re-lamb/ECE411_team14/Prototype/prototype1.jpg

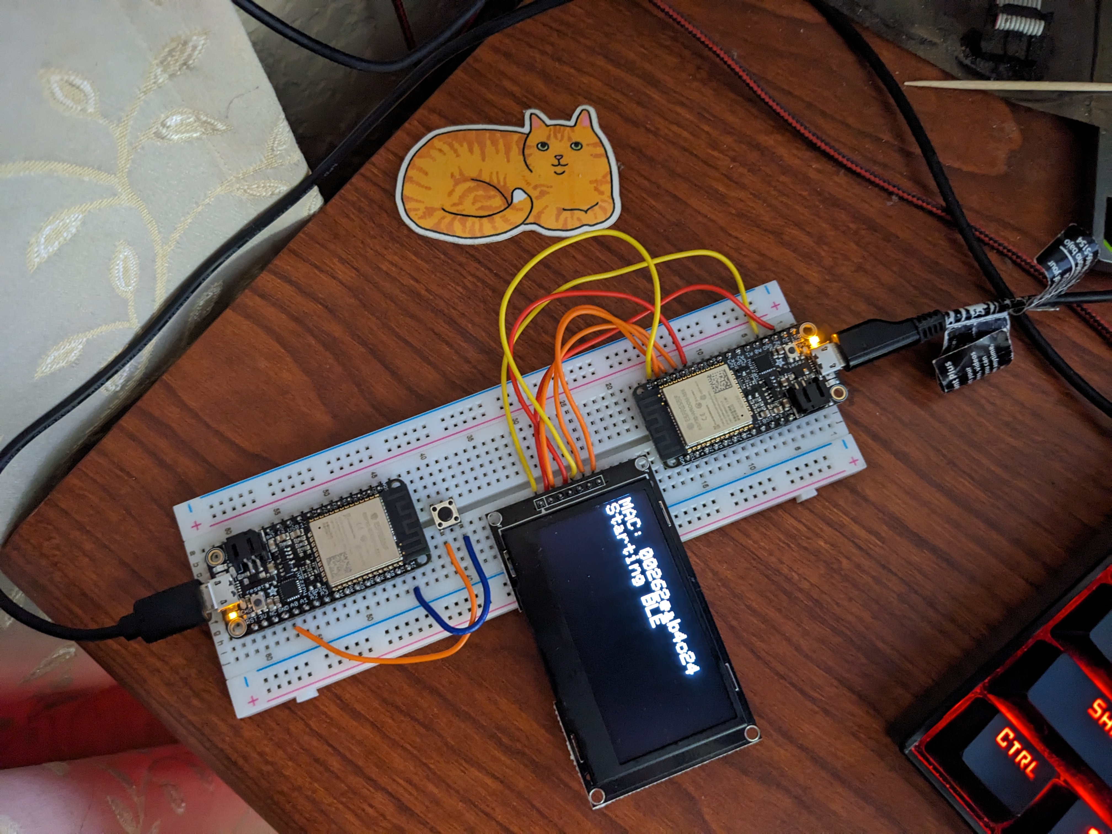
Prototype/prototype1.jpg
