re-lamb/ECE411_team14/README.md

# ECE411_team14
practicum for ece411 fall '23
