re-lamb/ECE411_team14/Documentation/Functional Decompositions - Team 14.pdf

Functional Decompositions
Team 14

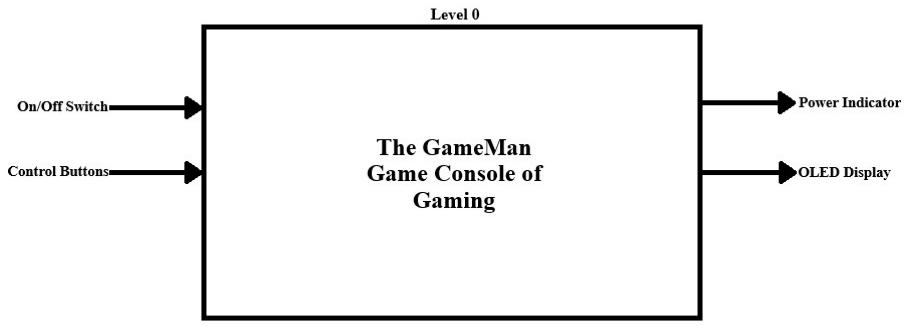
[picture p4: figure]
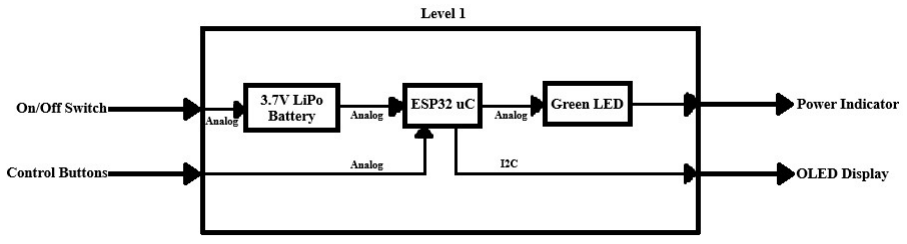
[picture p5: figure]
