re-lamb/ECE411_team14/Schematics/mazeye.gif

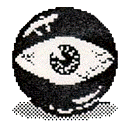
Schematics/mazeye.gif
