re-lamb/ECE411_team14/Scheduling/ECE411-GRP14_BILL.xlsx

Bill Of Materials for: Team 14
Last modified: 11/10/23
PCB version: 1
BOM revision: 1 |  | P/NP | = Place/Not Place (components marked NP are not stuffed on the board)
Cnt | Part References | P/NP | Mfg | Mfg PN | Description | Dist | Dist Part Number | Cost Ea. | Cost Total
1 |  | P | Adafruit Industries LLC | CFAL128128A0-015Y | MONOCHROME 1.12" 128X128 OLED | Digi-Key | 1528-5297-ND | $17.02 | $17.02
1 |  | P | RF Solutions | ESP-32 | Adafruit HUZZAH32 – ESP32 Feather Board | Digi-Key | ESP-32-ND | $10.00 | $10.00
1 | R4 | P | Stackpole Electronics INC | CF14JT330R | RES 330 OHM 5% 1/4W AXIAL | Digi-Key | CF14JT330RTR-ND | $0.10 | $0.10
1 | J1, J2 | P | E-Switch | EG1201A | SWITCH SLIDE SPDT 200MA 30V | Digi-Key | EG1902-ND | $0.76 | $0.76
3 | SW1 SW5 J2 | P | Alpha WIre | 3075 RD001 | HOOK-UP STRND 18AWG RED | Digi-Key | A2103R-1000-ND | $0.28 | $0.84
6 | SW2 SW3 SW4 SW6 SW7 J2 | P | CNC Tech | 1569-22-1-0500-001-1-TS | HOOK-UP STRAND 22AWG BLACK | Digi-Key | CN528B-500-ND | $0.14 | $0.84
2 | Both buttons | P | SparkFun Electrnics | COM-09032 | JOYSTICK 10K OHM 2 AXIS TH | Digi-Key | 1568-1526-ND | $4.50 | $9.00
 |  |  |  |  |  |  |  | TOTAL: | $38.56
VERSION INFO
Rev | Date | Notes
1.0r1 | 2020-11-19 | Cleaned up parts, rough draft of board
1.0r0 | 2020-11-12 | Initial BOM. Not everything chosen, lots wrong. Mostly just exported from EAGLE.
