re-lamb/ECE411_team14/Schematics/3D/258-1200mAh-lipo.step

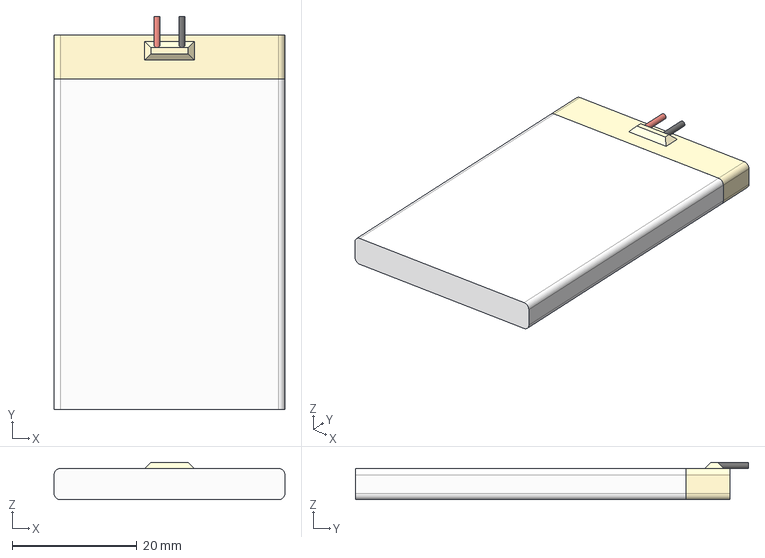
[picture p7: CAD file, 2023-11-16]
Schematics/3D/258-1200mAh-lipo.step
37.0 x 63.0 x 6.00 mm
