re-lamb/ECE411_team14/Schematics/3D/4741-1.5-inch-OLED.step

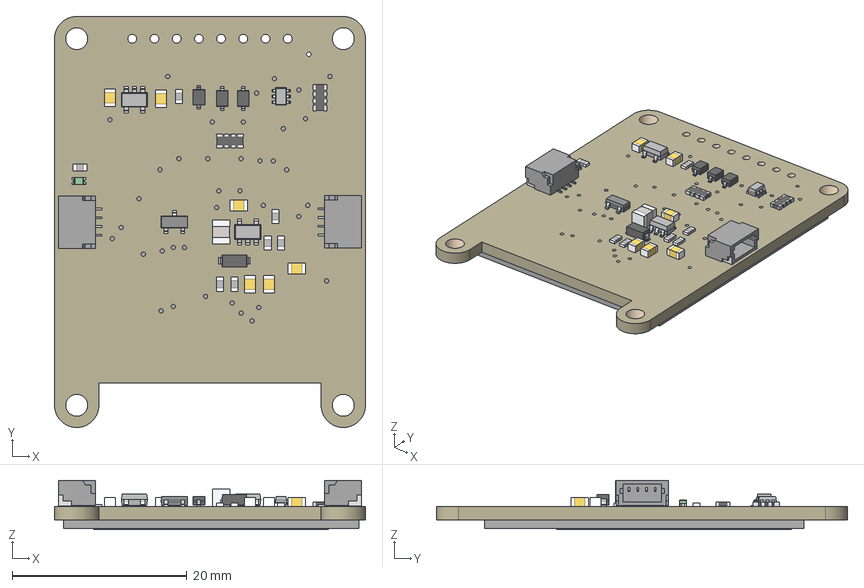
[picture p8: CAD file, 2023-11-16]
Schematics/3D/4741-1.5-inch-OLED.step
35.6 x 47.0 x 5.63 mm
Board
10uF x 6
AP2112K-3.3
0.1uF x 7
10K x 2
BSS138
STEMMA_I2C_QT x 2
GREEN
APX803
1N4148 x 3
OLED_1.5_128X128_MONO
FAN5331SX
10uH
MBR120
