re-lamb/ECE411_team14/Schematics/3D/S2B-PH-SM4-TB-LF-SN.step

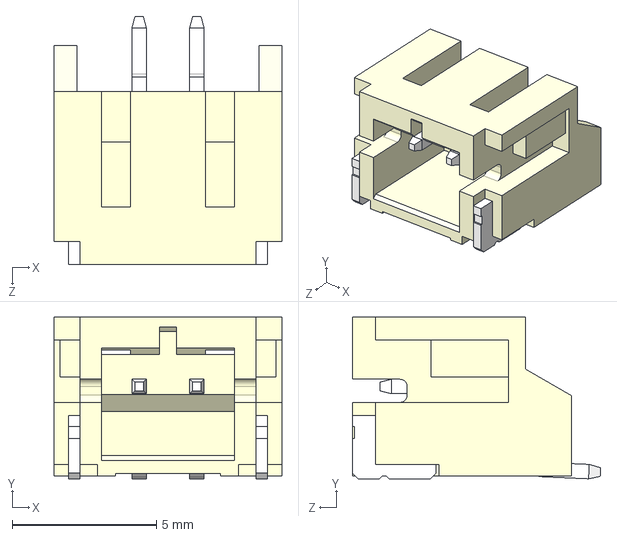
[picture p9: CAD file, 2023-11-16]
Schematics/3D/S2B-PH-SM4-TB-LF-SN.step
7.90 x 5.60 x 8.60 mm
