re-lamb/ECE411_team14/Schematics/3D/10118194-0001LF.step

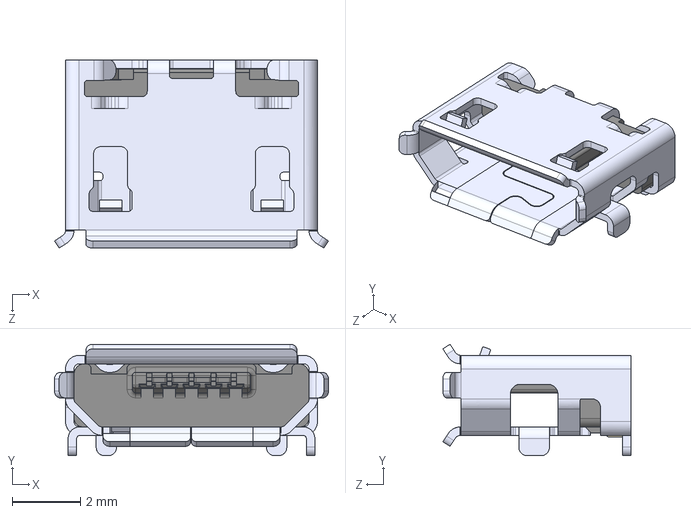
[picture p11: CAD file, 2023-11-16]
Schematics/3D/10118194-0001LF.step
8.05 x 3.27 x 5.53 mm
