re-lamb/ECE411_team14/Schematics/Docs/20329-Drawing.pdf

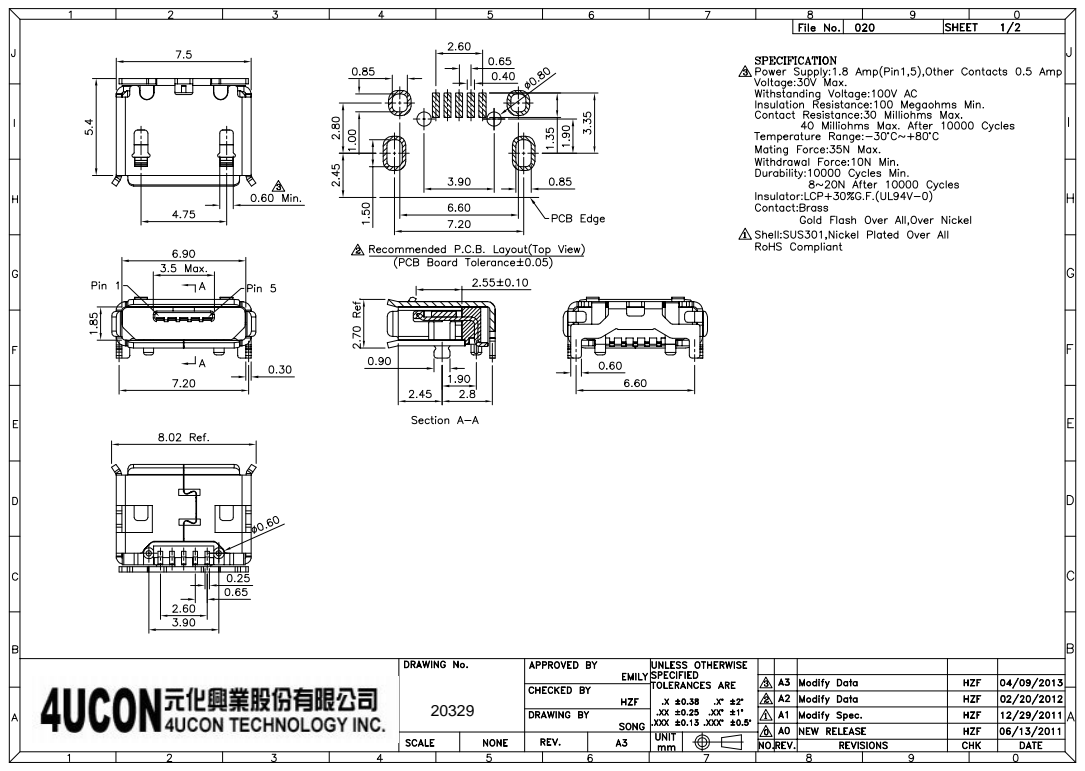
[picture p12: page 1]

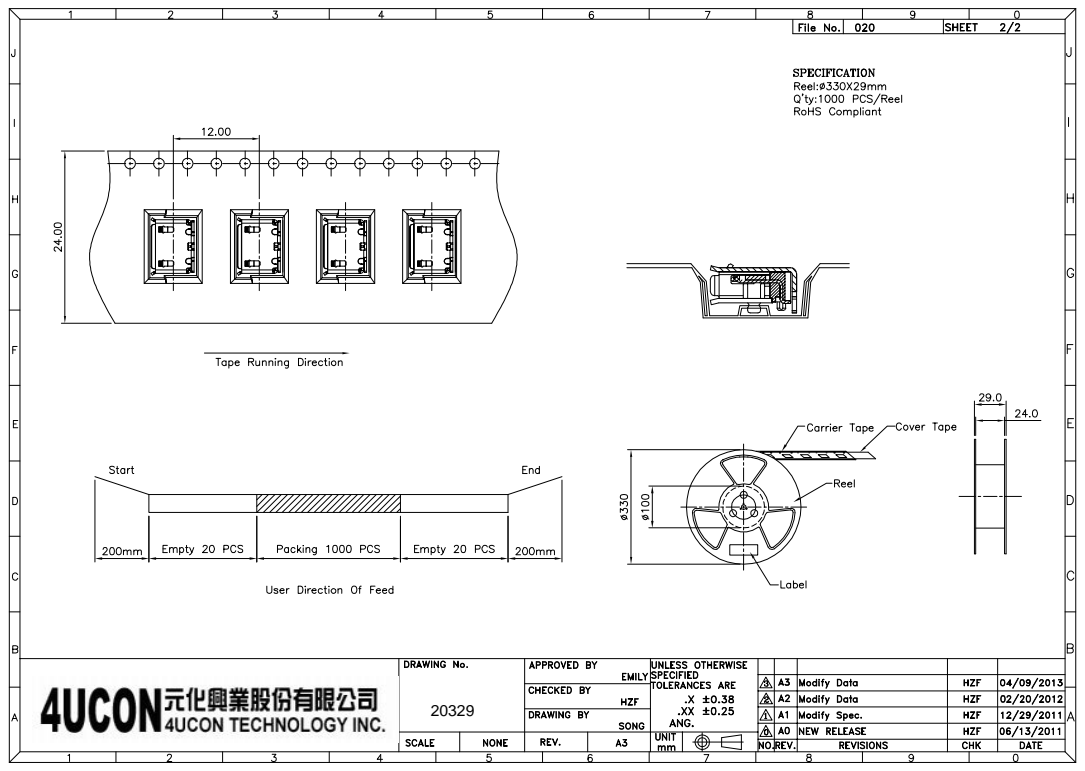
[picture p13: page 2]
