re-lamb/ECE411_team14/Schematics/Docs/huzzah32.pdf

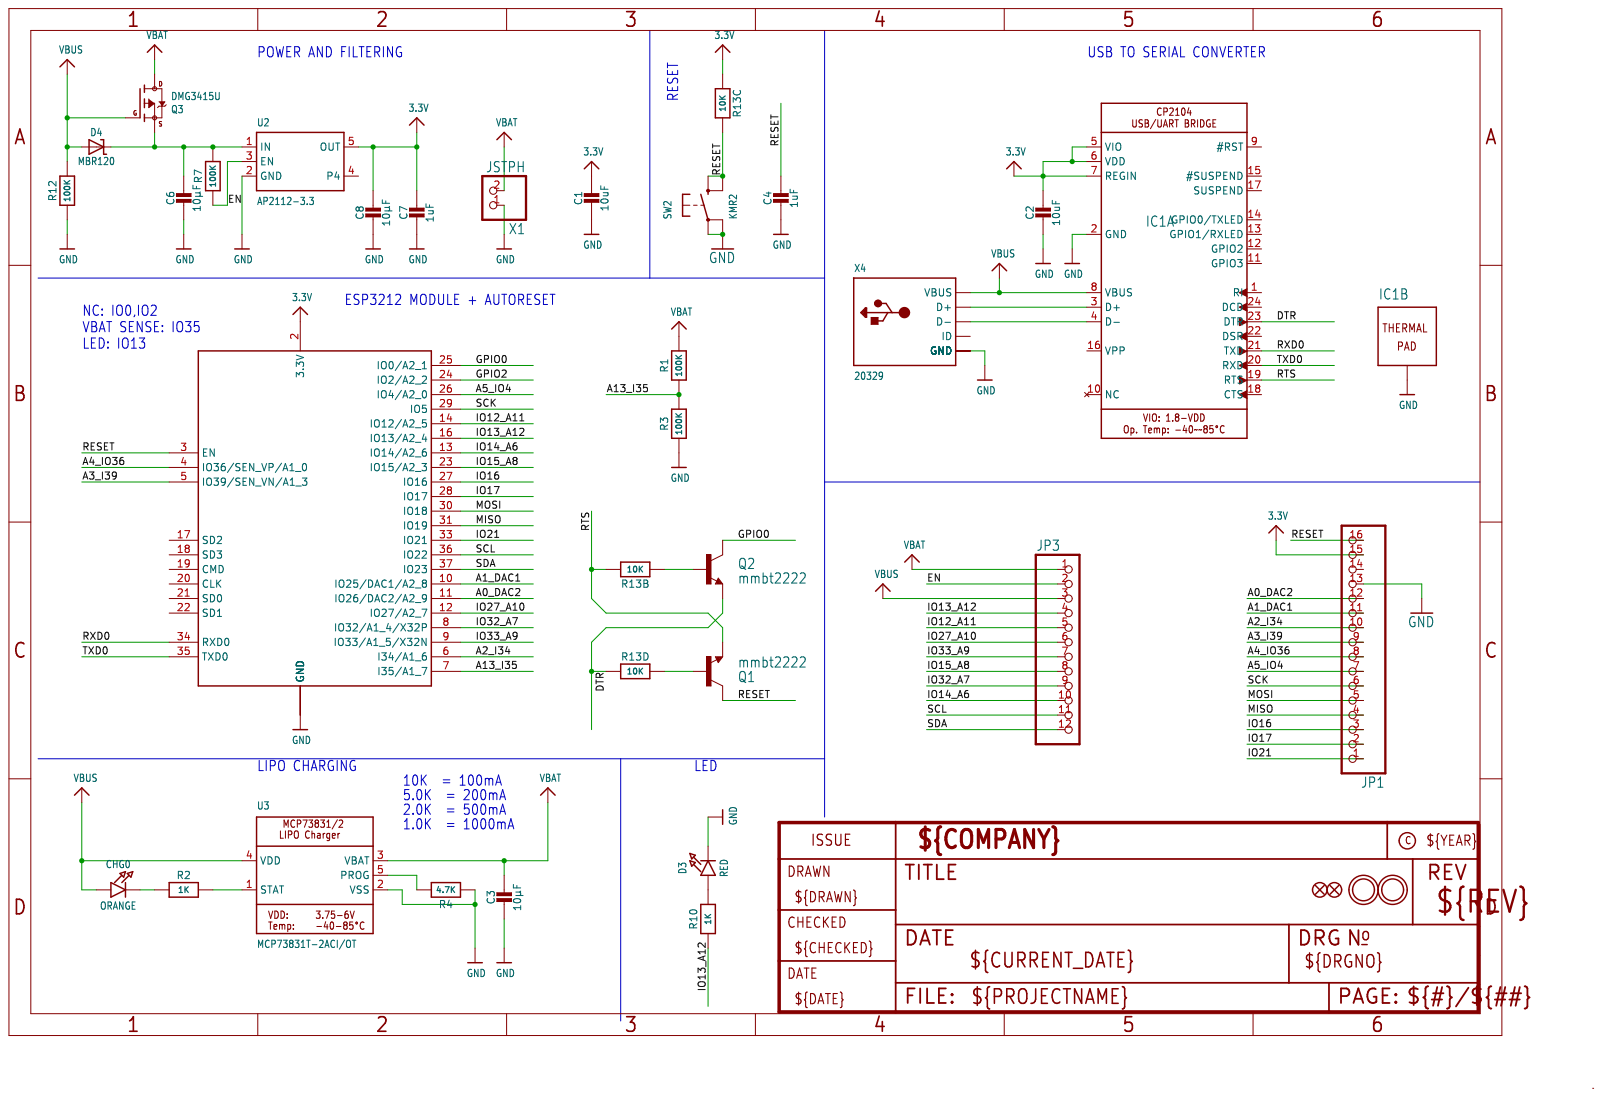
[picture p14: page 1]
