re-lamb/ECE411_team14/Schematics/GameMan.kicad_pcb

## KiCad design Schematics/GameMan.kicad_pcb (2023-11-16)

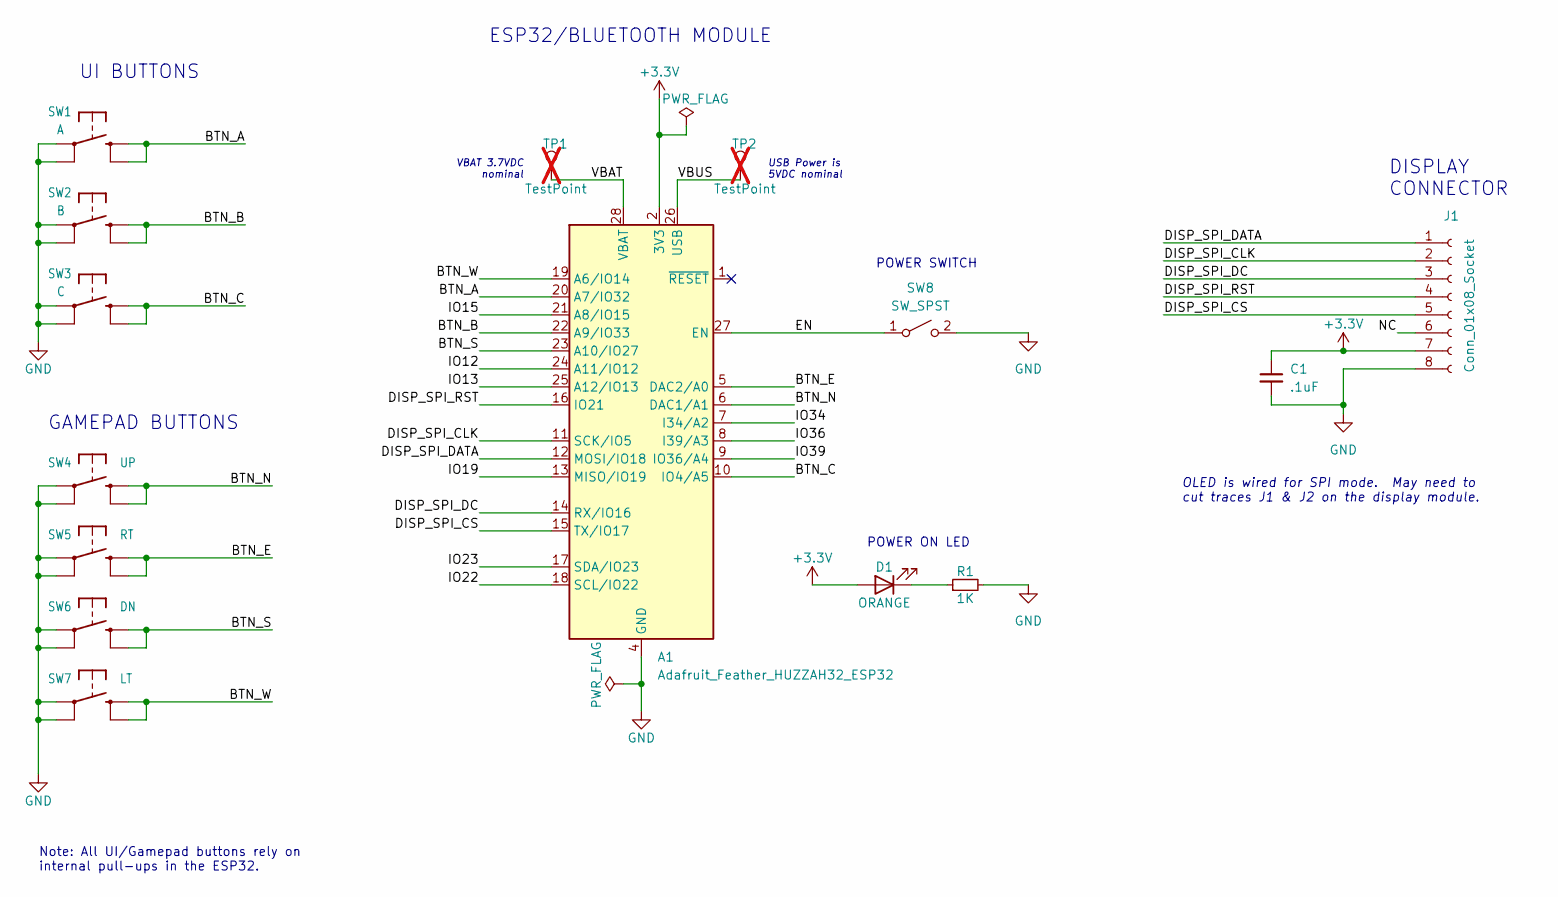
[picture p15: schematic GameMan.kicad_sch, GAMEMAN HANDHELD SCHEMATIC]

Parts:
A1: Adafruit_Feather_HUZZAH32_ESP32; Adafruit_Feather
C1: .1uF; 0805-NO
D1: ORANGE; CHIPLED_0805_NOOUTLINE
J1: Conn_01x08_Socket; Adafruit_SSD1327
R1: 1K; 0805-NO
SW1: A; SW_SPST_PTS645
SW2: B; SW_SPST_PTS645
SW3: C; SW_SPST_PTS645
SW4: UP; SW_SPST_PTS645
SW5: RT; SW_SPST_PTS645
SW6: DN; SW_SPST_PTS645
SW7: LT; SW_SPST_PTS645
SW8: SW_SPST; SW_SPDT_PCM12
TP1, TP2: TestPoint; PinHeader_1x01_P2.54mm_Vertical; not fitted

Connections:
+3.3V: A1.2 (3V3), C1.1, D1.2 (A), J1.7
/BTN_A: A1.20 (A7/IO32), SW1.2 (S)
/BTN_B: A1.22 (A9/IO33), SW2.2 (S)
/BTN_C: A1.10 (IO4/A5), SW3.2 (S)
/BTN_E: A1.5 (DAC2/A0), SW5.2 (S)
/BTN_N: A1.6 (DAC1/A1), SW4.2 (S)
/BTN_S: A1.23 (A10/IO27), SW6.2 (S)
/BTN_W: A1.19 (A6/IO14), SW7.2 (S)
/DISP_SPI_CLK: A1.11 (SCK/IO5), J1.2
/DISP_SPI_CS: A1.15 (TX/IO17), J1.5
/DISP_SPI_DATA: A1.12 (MOSI/IO18), J1.1
/DISP_SPI_DC: A1.14 (RX/IO16), J1.3
/DISP_SPI_RST: A1.16 (IO21), J1.4
/EN: A1.27 (EN), SW8.1 (A)
/IO12: A1.24 (A11/IO12)
/IO13: A1.25 (A12/IO13)
/IO15: A1.21 (A8/IO15)
/IO19: A1.13 (MISO/IO19)
/IO22: A1.18 (SCL/IO22)
/IO23: A1.17 (SDA/IO23)
/IO34: A1.7 (I34/A2)
/IO36: A1.8 (I39/A3)
/IO39: A1.9 (IO36/A4)
/NC: J1.6
/VBAT: A1.28 (VBAT), TP1.1
/VBUS: A1.26 (USB), TP2.1
GND: A1.4 (GND), C1.2, J1.8, R1.2, SW1.1, SW2.1, SW3.1, SW4.1, SW5.1, SW6.1, SW7.1, SW8.2 (B)
unnamed: D1.1 (K), R1.1

Notes on the sheet:
USB Power is 5VDC nominal
POWER SWITCH
UI BUTTONS
POWER ON LED
Note: All UI/Gamepad buttons rely on internal pull-ups in the ESP32.
ESP32/BLUETOOTH MODULE
GAMEPAD BUTTONS
DISPLAY CONNECTOR
OLED is wired for SPI mode. May need to cut traces J1 & J2 on the display module.
VBAT 3.7VDC nominal

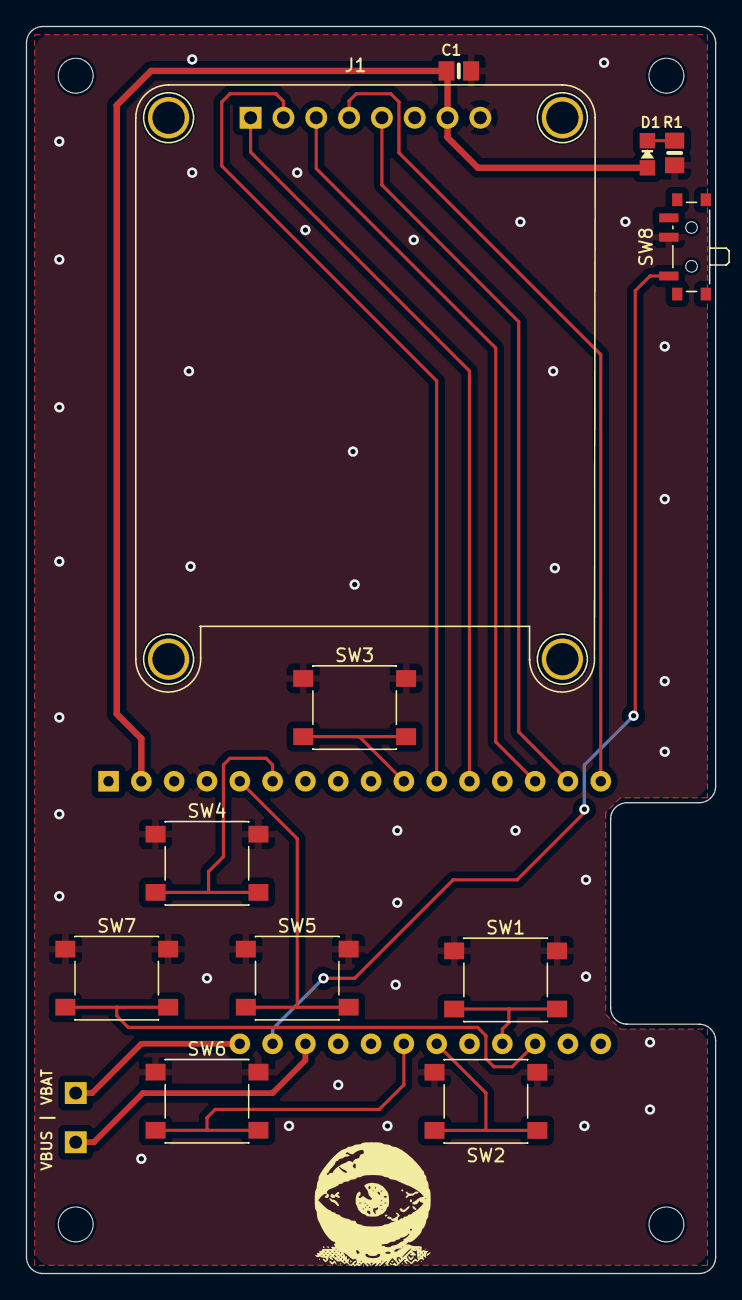
[picture p16: board GameMan.kicad_pcb from above]

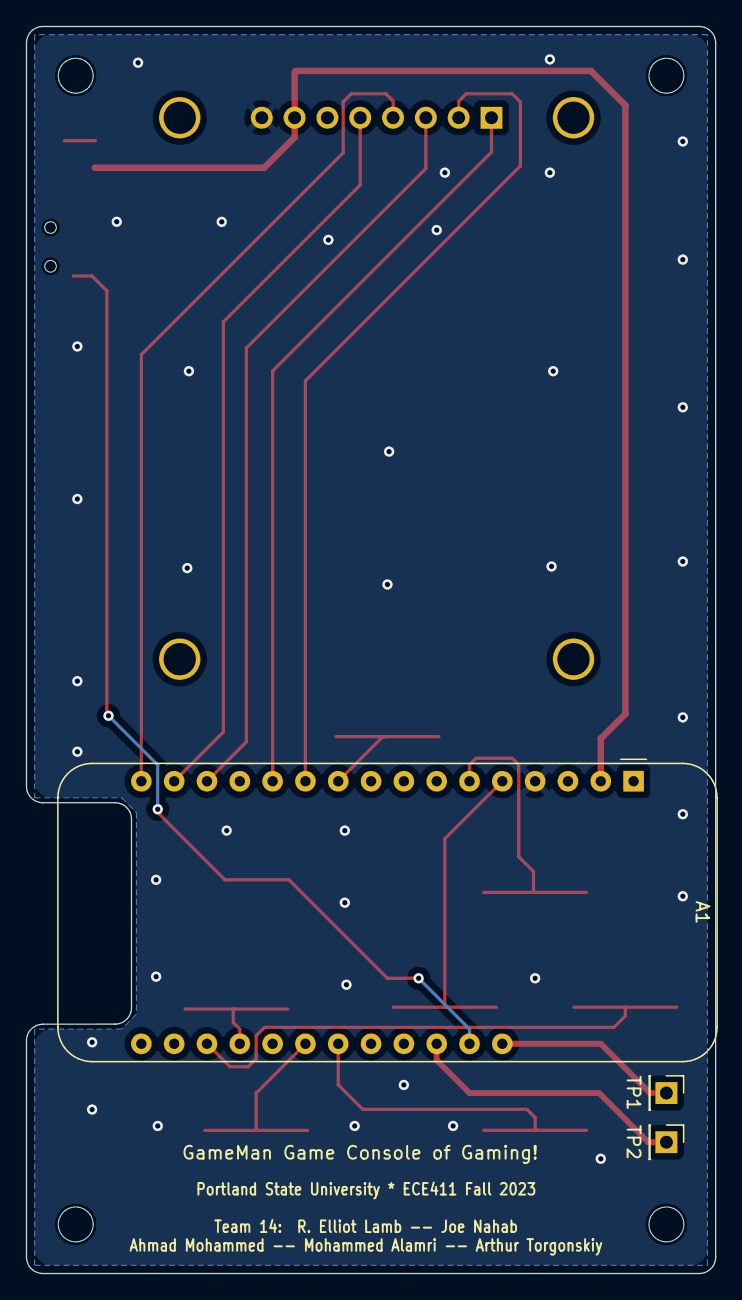
[picture p17: board GameMan.kicad_pcb from below]

Board: 2 copper layers, 53.3 x 96.5 mm, 15 parts (3 on the bottom side), 18 nets.
