re-lamb/ECE411_team14/Code/graphics.h

/*
 *  graphics.h - Basic bitmaps/icons/splash screen
 *
 *  Abstract:
 *      Contains one-bit monochrome (and 4bpp gray?) bitmaps in
 *      a C array format, compiled in rather than loaded from a
 *      separate flash partition.  Less flexible but easier to
 *      manage!
 *
 *  Team 14 Project
 *  Portland State University
 *  ECE411 Fall 2023
 */

#ifndef _GM_GFX_H_
#define _GM_GFX_H_

#define SPLASH_SM   32
#define SPLASH_MED  64
#define SPLASH_LG   128

#define WHITE       0x0F    // SSD1327_WHITE
#define HALF_BRIGHT 0x07    // should be a medium gray?
#define DARK_GRAY   0x03    // about 3/4 dark?  season to taste
#define BLACK       0x00    // SSD1327_BLACK

// "About" menu icon
static const uint8_t PROGMEM about16_bmp[] = {
  0xff, 0xff, 0xf8, 0x1f, 0xf6, 0x0f, 0xe8, 0x07, 
  0xc0, 0x03, 0xc7, 0xf3, 0xdf, 0x3d, 0xfc, 0x3d, 
  0xdc, 0xb9, 0xc7, 0xf3, 0xc1, 0x83, 0xe0, 0x07, 
  0xf0, 0x6f, 0xfa, 0x0f, 0xfc, 0x7f, 0xff, 0xff
};

// "SysInfo" menu icon
static const uint8_t PROGMEM info16_bmp[] = {
  0xf8, 0x1f, 0xe3, 0xe7, 0xcf, 0x33, 0x9f, 0x19,
  0xbf, 0xfd, 0x3e, 0x3c, 0x7e, 0x3e, 0x7c, 0x7e,
  0x7c, 0x7e, 0x78, 0xfe, 0x38, 0xfe, 0xb8, 0xbd,
  0x9c, 0x79, 0xcf, 0xf3, 0xe3, 0xc7, 0xf8, 0x1f
};

// "TicTacToe" menu icon
static const uint8_t PROGMEM ttt16_bmp[] = {
  0xff, 0xff, 0xfb, 0xdf, 0xfb, 0xdf, 0xfb, 0xdf,
  0x80, 0x01, 0xfb, 0xdf, 0xfb, 0xdf, 0xfb, 0xdf,
  0xfb, 0xdf, 0xfb, 0xdf, 0xfb, 0xdf, 0x80, 0x01,
  0xfb, 0xdf, 0xfb, 0xdf, 0xfb, 0xdf, 0xff, 0xff
};

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
  0xff, 0xff, 0x00, 0x00, 0x00, 0x00, 0x39, 0xff, 0xff, 0xfe, 0x00, 0x00, 0x00, 0x00, 0x3f, 0xff, 
  0xff, 0xff, 0x00, 0x00, 0x00, 0x00, 0x7f, 0xff, 0xff, 0xff, 0x00, 0x00, 0x00, 0x00, 0x3f, 0xff, 
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
};

#endif
