re-lamb/ECE411_team14/(commit log)

2023-10-26 Schematic v1
2023-10-26 Schematic v1 - 10/25/23
2023-10-26 Create README.txt
    created readme for schematics folder
2023-10-26 Delete Schematic v1 - The GameMan Game Console of Gaming.pdf
    moving to schematics folder
2023-10-26 Delete The GameMan Game Console of Gaming - Schematic v1.pdf
    wrong ver.
2023-10-26 Schematic v1.0 - 10/25/23
    [gameman v1.0 schematic.kicad_sch]
2023-11-02 Add files via upload
    Prototype status update
2023-11-02 Layout chematics v1.0
    [gameman schematic v1.0 - no OLED.kicad_pcb, gameman schematic v1.0.kicad_pcb]
2023-11-02 PCB Schematic v1.0
2023-11-14 BOM - 11/9/23
    [ECE411-GRP14_BILL.xlsx]
2023-11-14 PCB Layout & Schematic v1.0e
2023-11-16 Delete Schematics directory
    Replacement on the way
    [gameman schematic v1.0 - no OLED.kicad_pcb, gameman schematic v1.0.kicad_pcb, gameman v1.0 schematic.kicad_sch]
2023-11-16 Add files via upload
    Version 2 schematic and PCB
    [10118194-0001LF.step, 258-1200mAh-lipo.step, 3405 Adafruit HUZZAH32 ESP32 Feather.step, 4741-1.5-inch-OLED.step, GameMan.csv, GameMan.kicad_pcb, GameMan.kicad_sch, S2B-PH-SM4-TB-LF-SN.step]
2023-11-20 Add files via upload
    task framework for doing initialization/IO/menus
2023-12-08 version 0.85 snapshot. memory leaks abound.
    [GameMan.ino, about.cpp, about.h, graphics.h, menu.cpp, menu.h, network.cpp, network.h]
